funkysub-commits/solar_car/docs/SolarCarChallenge2026_Checklist Andy.md

# Solar Car Challenge 2026

Team Checklist — Items Outside the Car Build

## Andy notes:

Telemetry systems may have a common ground with the propulsion system, as long as the current draw is low

Liquid Container – Cockpits must be equipped with a plastic liquid container filled with water, which can be easily reached by the driver. The liquid container must be secured from movement such that it cannot roll underneath the brake and throttle controls

Fire Extinguishers – Cockpits must be equipped with a Class C fire extinguisher which can be easily reached by the driver in the event of an emergency. Chase vehicles must also be equipped with either a Class C fire extinguisher (for lead-acid batteries), a Class D fire extinguisher (for Lithium-metal batteries), or an appropriate fire extinguisher for other battery chemistries.

Assembled from the 2026 Solar Car Challenge (solarcarchallenge.org) rules and event calendar. Verify every item and date against your current copy of the rules, event updates, and the “Where-to-Be, What-to-Do” document before relying on this list.

“High Voltage” warning signs

Fasteners – All fasteners associated with the vehicle’s suspension, steering, brakes, seat belts, and drive train must be equipped with locking nuts, double nuts, or nuts secured with safety wire or Copyright (c) 2025 Lehman Marks. All Rights Reserved. cotter pins. Loctite may be used in areas of difficult accessibility. When nylon locking nuts are used, the bolt must extend past the nut by at least two threads

Sponsored Graphics – Teams must reserve a space 10" (horizontal) by 10" (vertical) on both sides of the vehicle for official event graphics. The sponsor graphics location should be near the front of the solar car.

Charging accessory battery..?

welding curtain

add email address to iphone group chat so we can see messages on ipad?

“how to receive message on ipad with no phone number with imessage”

All support vehicles on the course must have roof-mounted flashing amber lights mounted at the rear of the vehicle.

Umbilical Cord – To position a solar car’s solar array in a favorable position for charging, an umbilical cord may be used. This cord must be carried on the solar car

Prop car up to face the sun?

### Support Vehicles & Convoy

| **✓** | **Item** | **Owner** | **Deadline / Notes** |
| --- | --- | --- | --- |
| ☐ | Lead vehicle for cross-country events |  |  |
| ☐ | Chase vehicle(s); No. 1 chase must have front-seat space for the event judge |  |  |
| ☐ | Two-way radios for the caravan (car ↔ chase ↔ lead) |  |  |
| ☐ | Radio communication link between support vehicles |  |  |
| ☐ | Amber flashers / warning lights on support vehicles |  |  |
| ☐ | Truck and trailer for trailering the car |  |  |
| ☐ | Support-vehicle signage / team identification |  |  |

### On-Road & Pit Safety Equipment

| **✓** | **Item** | **Owner** | **Deadline / Notes** |
| --- | --- | --- | --- |
| ☐ | Traffic cones or warning triangles |  |  |
| ☐ | Orange warning flags |  |  |
| ☐ | Safety vests (driver, safety officer, anyone on track or road) |  |  |
| ☐ | Jack stands (required whenever car is worked on) |  |  |
| ☐ | Fire extinguisher – at least one with 10 lb capacity |  |  |
| ☐ | Cockpit fire extinguisher – Class C, within driver's reach |  |  |
| ☐ | Chase-vehicle extinguisher – Class C (lead-acid) / Class D (lithium-metal) / battery-appropriate |  |  |
| ☐ | First-aid supplies |  |  |
| ☐ | Protective eyewear for garage work (penalty if not worn) |  |  |

### Battery / Electrical Safety

| **✓** | **Item** | **Owner** | **Deadline / Notes** |
| --- | --- | --- | --- |
| ☐ | Battery spill kit (box of baking soda), in reach of driver – lead-acid teams |  |  |
| ☐ | Second battery spill kit – lead-acid teams |  |  |

### Driver Gear

| **✓** | **Item** | **Owner** | **Deadline / Notes** |
| --- | --- | --- | --- |
| ☐ | Helmet (not mandatory, highly recommended) |  |  |

### Required Documents & Submissions

| **✓** | **Item** | **Owner** | **Deadline / Notes** |
| --- | --- | --- | --- |
| ☐ | Intent to Race filing |  | Deadline Jan 31, 2026 |
| ☐ | Official Registration Documents & Fees |  | Deadline Mar 1, 2026 |
| ☐ | Proof of liability insurance on the car |  | By Jun 1, 2026 (cross-country) |
| ☐ | Team scrapbook – digital copy (becomes SCC property) |  | Deadline Jun 15, 2026 |
| ☐ | Team video |  | Deadline Jul 1, 2026 |
| ☐ | Oral presentation with visual aids |  | At event |
| ☐ | Release-of-liability forms |  | Per event updates |

### Team Logistics & Provisions

| **✓** | **Item** | **Owner** | **Deadline / Notes** |
| --- | --- | --- | --- |
| ☐ | Chaperones / adult supervision |  |  |
| ☐ | Team ID tags – event provides up to 15; larger teams arrange in advance |  |  |
| ☐ | Water beyond event-provided points (start, required stops, impound, qualifiers) |  |  |
| ☐ | Toolboxes by task (front/rear tire changes, mechanical, electrical) |  |  |
| ☐ | Lodging, meals, and fuel for cross-country |  |  |

> [!TIP]
> the longest-lead items are usually the support vehicles, radios, trailer, and insurance — start those first.
