funkysub-commits/solar_car/docs/QR codes.md

## Telemetry User Guide

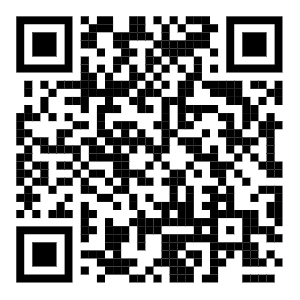
[picture p10: docs/QR codes_images/image-000.png]


## Map with elevation

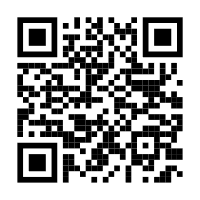
[picture p11: docs/QR codes_images/image-001.png]


## Telemetry Code Design Docs

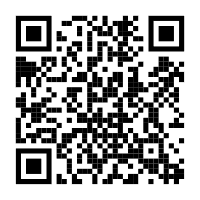
[picture p12: docs/QR codes_images/image-002.png]
Design Docs
