funkysub-commits/solar_car/data_processing/team_pack/2026-10-03/details/figures/drive_06.png

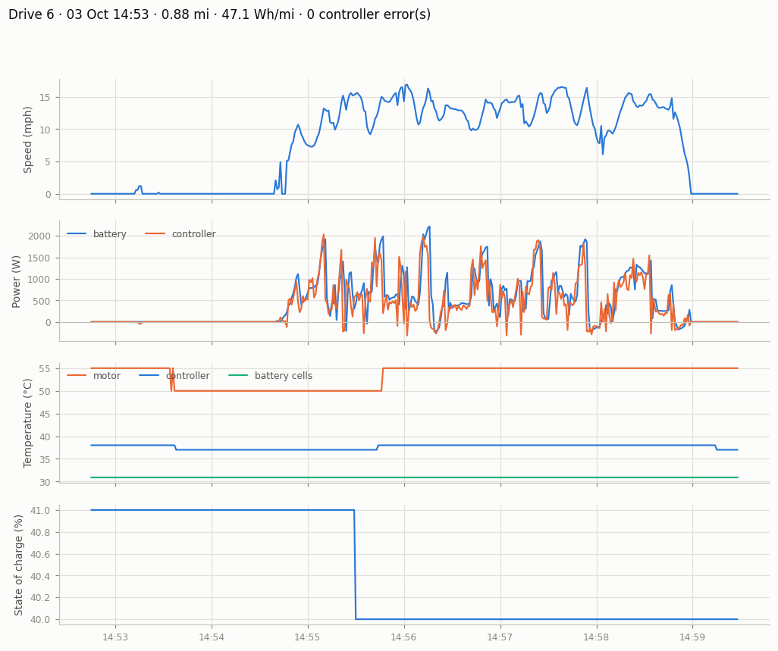
data_processing/team_pack/2026-10-03/details/figures/drive_06.png
