funkysub-commits/solar_car/readme_assets/ha_app.png

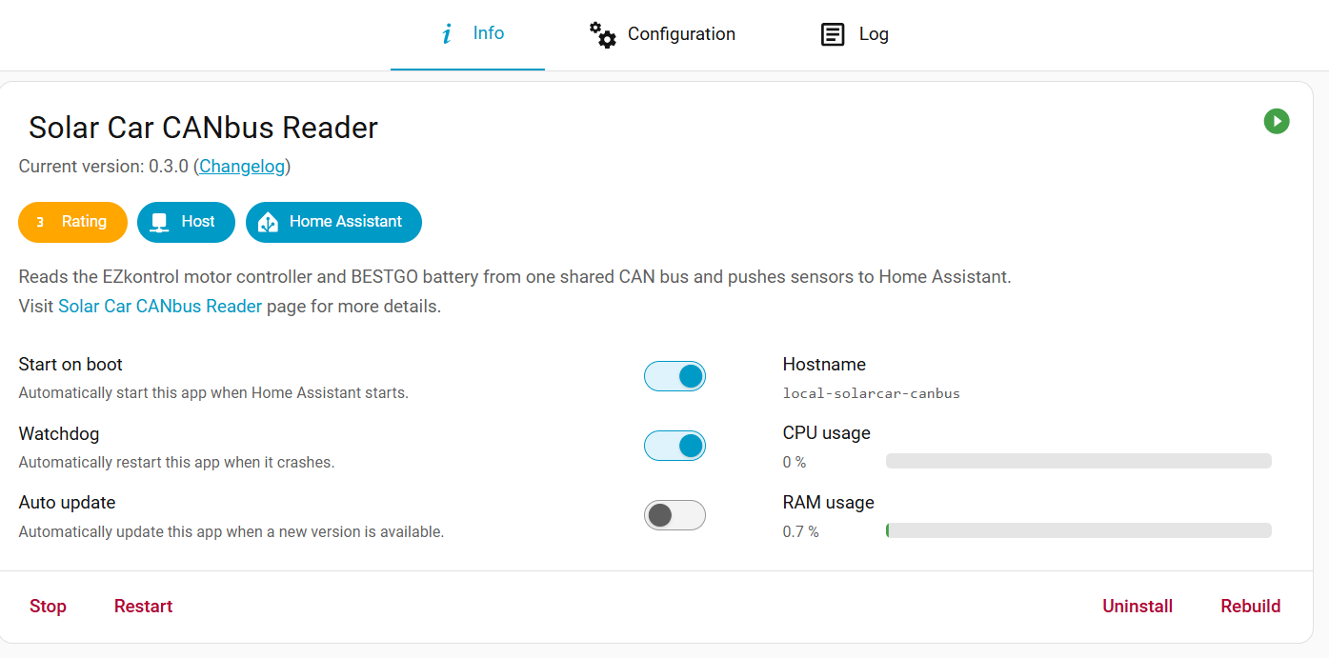
readme_assets/ha_app.png
