funkysub-commits/solar_car/TODO.md

# To Do

- [ ] Make the can bus work with both devices!!!
    - [ ] Check the wiring
    - [x] Manually review code
    - [x] AI review code
- [ ] Fix the can adapter having to power cycle
- [ ] Add startup checklist to power off screen - text box in config
- [x] Add mph calculator
- [ ] Calculate distance/odometer
- [ ] Calculate kw per mile over the last mile?
- [ ] Add estimated remaining miles - based on current pace
- [ ] Connect aux bat to the bms_ble add on - needs update to HAOS
- [x] hardware connection for aux bat to router and pi
- [x] Implement audio player
- [ ] Physically add audio player to car
- [X] Add IP address QR codes to home assistant page
- [x] Add a (physical) switch to the power to the pi and router
- [x] Retain entity values on restart
- [ ] Manage documentation
    - [ ] Finish Evana telemetry userguide
    - [ ] show travelers how to add hotspot and enable/test tailscale from Euan/Andy device over the internet
- [x] Eat an ice cream bar
- [x] Eat another ice cream bar
- [x] Eat a popsicle, or 2
- [x] Eat some oreos
