funkysub-commits/solar_car/CANbus_data/ha_addons/solar-car-canbus/can_reader.py

#!/usr/bin/env python3
"""Solar Car CANbus reader for Home Assistant.

Reads two devices from ONE shared CAN bus (an SH-C31G on slcan firmware,
opened as a serial port via python-can) and pushes named sensor states to HA
via the REST API:

  * EZkontrol B48800 motor controller  -- 29-bit extended IDs (0x1801xxxx)
  * BESTGO battery (Lithium Valley BMS) -- 11-bit standard IDs (0x351..0x379)

The ID ranges don't overlap, so a single socket sees and decodes both. Each
device has an independent push interval and dummy-mode flag, set in the
add-on options and passed through by run.sh as environment variables.

The frame protocols live in the shared solarcar_can package; the copy next
to this file is VENDORED from CANbus_data/solarcar_can/ by sync_addon.py
(HA builds local add-ons with this folder as the Docker context, so the
package has to be carried inside it). Edit the original, then re-sync.
"""
import os
import glob
import time
import queue
import socket
import struct
import logging
import threading

import requests

from solarcar_can import bestgo, ezkontrol
from solarcar_can.bestgo import BestgoDecoder, BG_SENSORS
from solarcar_can.ezkontrol import EzkontrolDecoder, EZ_SENSORS
import telemetry_export

logging.basicConfig(level=logging.INFO,
                    format='%(asctime)s %(levelname)s %(message)s')

HA_URL = os.environ.get("HA_URL", "http://supervisor/core")
HA_TOKEN = os.environ.get("HA_TOKEN", "")
CAN_PORT = os.environ.get("CAN_PORT", "")   # slcan serial port; "" = auto-detect
CAN_BITRATE = os.environ.get("CAN_BITRATE", "500000")

BUS_RETRY_SEC = 10       # how often to retry opening a lost/missing CAN bus
STATUS_MISS_INTERVALS = 3  # device status drops to 0 after this many silent push intervals
NET_INTERVAL = 10        # seconds between host-network checks (runs off-thread)
NET_TIMEOUT = 1.5        # per-probe TCP connect timeout
PUSH_QUEUE_MAX = 256     # pending HA pushes; oldest dropped first when HA lags

EZKONTROL_DUMMY = os.environ.get("EZKONTROL_DUMMY", "false").lower() == "true"
EZKONTROL_PUSH_INTERVAL = int(os.environ.get("EZKONTROL_PUSH_INTERVAL", "2"))
BESTGO_DUMMY = os.environ.get("BESTGO_DUMMY", "false").lower() == "true"
BESTGO_PUSH_INTERVAL = int(os.environ.get("BESTGO_PUSH_INTERVAL", "5"))

# Live update interval: the HA number helper INTERVAL_ENTITY (seconds) is
# polled every CONTROL_POLL_SEC and, when present, overrides BOTH devices'
# push intervals (and so how finely HA records history) -- changeable from the
# dashboard at any time, no restart. Without the helper each device uses its
# configured push interval. Values are clamped to [INTERVAL_MIN, INTERVAL_MAX].
# Only values that CHANGED are re-POSTed faster than a device's configured
# interval (HA ignores identical states anyway, so this only saves HTTP load);
# unchanged values are still re-sent at the configured cadence.
INTERVAL_ENTITY = os.environ.get("INTERVAL_ENTITY", "input_number.canbus_update_interval")
INTERVAL_MIN, INTERVAL_MAX = 0.1, 60.0
CONTROL_POLL_SEC = 2.0   # how often the HA helper is re-read

# Telemetry export (telemetry_export.py): nothing is logged to disk; on
# request the add-on pulls the recorded history of every telemetry entity
# from HA and streams one wide CSV. EXPORT_EXTRA_ENTITIES adds entities the
# add-on doesn't own (e.g. the rpm->mph template sensor); missing ones are
# simply blank columns.
EXPORT_PORT = int(os.environ.get("EXPORT_PORT", "8099"))   # fixed: ingress_port in config.yaml
EXPORT_EXTRA_ENTITIES = [e.strip() for e in os.environ.get("EXPORT_EXTRA_ENTITIES", "").split(",")
                         if e.strip()]

HEADERS = {
    "Authorization": f"Bearer {HA_TOKEN}",
    "Content-Type": "application/json",
}


class Device:
    """One CAN device: its decoder, dummy generator, sensors and push timer."""

    def __init__(self, name, prefix, dummy, push_interval,
                 decoder, dummy_fn, sensors, summary_fn):
        self.name = name
        self.prefix = prefix
        self.dummy = dummy
        self.push_interval = push_interval
        self.decoder = decoder
        self.dummy_fn = dummy_fn
        self.sensors = sensors
        self.summary_fn = summary_fn
        self.data = {}
        self.good_data = False
        self.last_push = 0.0
        self.last_summary = 0.0      # last summary log line (throttled to push_interval)
        self.last_status_push = 0.0  # status sensor keeps the configured cadence
        self.last_rx = 0.0       # when this device last claimed a frame (monotonic)
        self.last_status = None  # last pushed status value (for change logging)

    def decode(self, arb_id, raw):
        """Decode a frame into self.data. Return True if it belonged here."""
        fields = self.decoder.decode(arb_id, raw)
        if fields is None:
            return False
        self.data.update(fields)
        self.last_rx = time.monotonic()
        return True

    def status(self, now):
        """1 if this device is alive: dummy mode counts as alive; live mode
        requires a frame within STATUS_MISS_INTERVALS push intervals. Always
        judged against the CONFIGURED interval, so a fast live interval never
        makes a healthy device read 0."""
        if self.dummy:
            return 1
        return 1 if (now - self.last_rx) <= STATUS_MISS_INTERVALS * self.push_interval else 0

    def effective_interval(self, live):
        """Seconds between pushes right now: the live HA setting when the
        helper exists, otherwise this device's configured interval."""
        return live if live is not None else self.push_interval


# entity_id -> (last pushed value as str, monotonic time it was queued).
# Used by push_device to skip re-POSTing an unchanged value sooner than the
# device's configured interval: identical state+attributes don't even bump
# last_updated in HA, so the request would be pure load on the Pi. The value
# is still re-sent once the configured interval has elapsed, so a restarted
# HA gets everything back within one cycle exactly as before. (At or above
# the configured interval this never skips anything.)
_last_sent = {}


def push_device(device, now=None):
    """POST the decoded fields of `device` to the HA REST API as sensors.

    Only fields listed in the device's sensor table are pushed; extra
    decoded fields (soc_hi, chemistry, life) stay dashboard-only so the
    published sensor set doesn't change.
    """
    now = time.monotonic() if now is None else now
    for key, value in device.data.items():
        cfg = device.sensors.get(key)
        if cfg is None:
            continue
        entity_id = f"sensor.{device.prefix}_{key}"
        prev = _last_sent.get(entity_id)
        if prev and prev[0] == str(value) and now - prev[1] < device.push_interval:
            continue
        _last_sent[entity_id] = (str(value), now)
        attrs = {
            "friendly_name": f"{device.name} {key.replace('_', ' ').title()}",
            "icon":          cfg.get("icon", "mdi:information"),
            "source":        "solar_car_canbus",
        }
        if cfg.get("unit"):
            attrs["unit_of_measurement"] = cfg["unit"]
        if cfg.get("device_class"):
            attrs["device_class"] = cfg["device_class"]
        push_state(entity_id, value, attrs)


# HTTP pushes run on their own thread (state_pusher below). Callers only
# enqueue, so a slow or restarting HA can never stall bus.recv() - blocking
# the read loop lets the kernel RX buffer overflow and silently drop frames.
_push_q = queue.Queue(maxsize=PUSH_QUEUE_MAX)
_push_drops = 0
_push_drop_logged = 0.0


def push_state(entity_id, value, attrs):
    """Queue one entity state for the pusher thread. Never blocks: when the
    queue is full (HA badly behind) the OLDEST update is dropped - every
    sensor is re-pushed each interval, so fresh values win."""
    global _push_drops, _push_drop_logged
    while True:
        try:
            _push_q.put_nowait((entity_id, value, attrs))
            return
        except queue.Full:
            try:
                _push_q.get_nowait()
                _push_drops += 1
            except queue.Empty:
                pass
            now = time.monotonic()
            if now - _push_drop_logged >= 30:
                _push_drop_logged = now
                logging.warning(f"push queue full - dropped {_push_drops} stale "
                                "updates so far (HA slow/unreachable?)")


def state_pusher(stop):
    """Daemon loop: POST queued entity states to the HA REST API."""
    session = requests.Session()
    while not stop.is_set():
        try:
            entity_id, value, attrs = _push_q.get(timeout=0.5)
        except queue.Empty:
            continue
        try:
            r = session.post(
                f"{HA_URL}/api/states/{entity_id}",
                headers=HEADERS,
                json={"state": str(value), "attributes": attrs},
                timeout=5,
            )
            if r.status_code not in (200, 201):
                logging.warning(f"{entity_id}: HTTP {r.status_code} {r.text[:200]}")
        except Exception as e:
            logging.error(f"{entity_id}: {e}")


class IntervalControl:
    """Mirrors the HA number helper INTERVAL_ENTITY (seconds between updates)
    into a thread-safe value. Polled on its own thread so the GET can never
    stall the CAN read loop. `value` is None while the helper is missing or
    unreadable (devices then fall back to their configured intervals), with
    a one-time hint in the log on how to create it."""

    def __init__(self):
        self._value = None
        self._lock = threading.Lock()
        self.missing_logged = False

    @property
    def value(self):
        with self._lock:
            return self._value

    def _set(self, v):
        with self._lock:
            old, self._value = self._value, v
        if v != old:
            if v is None:
                logging.info("update interval -> per-device configured intervals (helper unavailable)")
            else:
                logging.info(f"update interval -> {v:g}s (from {INTERVAL_ENTITY})")

    def run(self, stop):
        session = requests.Session()
        while not stop.is_set():
            try:
                r = session.get(f"{HA_URL}/api/states/{INTERVAL_ENTITY}",
                                headers=HEADERS, timeout=5)
                if r.status_code == 200:
                    state = r.json().get("state")
                    try:
                        v = min(INTERVAL_MAX, max(INTERVAL_MIN, float(state)))
                        self._set(round(v, 3))
                    except (TypeError, ValueError):     # unknown/unavailable
                        self._set(None)
                    self.missing_logged = False
                elif r.status_code == 404:
                    if not self.missing_logged:
                        logging.warning(
                            f"{INTERVAL_ENTITY} not found in HA: using the configured push "
                            "intervals. Create a Number helper with that entity id (or deploy "
                            "CANbus_data/ha/packages/canbus_controls.yaml).")
                        self.missing_logged = True
                    self._set(None)
                else:
                    logging.warning(f"interval poll: HTTP {r.status_code}")
            except Exception as e:
                logging.debug(f"interval poll: {e}")   # HA down: keep last value
            stop.wait(CONTROL_POLL_SEC)


INTERVAL = IntervalControl()


def push_device_status(device, now):
    """Push sensor.<prefix>_status (1 = alive, 0 = silent). Logs transitions."""
    val = device.status(now)
    if val != device.last_status:
        logging.info(f"{device.name} status -> {val}"
                     + ("" if val else f" (no frames for {STATUS_MISS_INTERVALS}x{device.push_interval}s)"))
        device.last_status = val
    push_state(f"sensor.{device.prefix}_status", val, {
        "friendly_name": f"{device.name} Status",
        "icon": "mdi:check-network" if val else "mdi:close-network",
        "source": "solar_car_canbus",
    })


def push_adapter_status(val):
    """Push sensor.canadapter_status (1 = CAN bus open, 0 = adapter missing/lost)."""
    push_state("sensor.canadapter_status", val, {
        "friendly_name": "CAN Adapter Status",
        "icon": "mdi:usb-port" if val else "mdi:usb-off",
        "source": "solar_car_canbus",
    })


# ===========================================================================
# Host network monitoring
#
# Runs on its own thread (NetworkMonitor) so its blocking TCP probes never
# stall the CAN read loop. The add-on has host_network, so these see the
# host's real interfaces -- the address other machines reach HA at, not HA
# core's internal container IP (which the built-in local_ip sensor reports).
# ===========================================================================
def host_ip():
    """Primary LAN IPv4 of the host, via the default-route source-IP trick
    (no packets sent). None when there's no usable LAN address."""
    ip = None
    s = socket.socket(socket.AF_INET, socket.SOCK_DGRAM)
    try:
        s.connect(("1.1.1.1", 80))   # picks the source IP for the default route
        ip = s.getsockname()[0]
    except OSError:
        pass
    finally:
        s.close()
    if ip and not ip.startswith("127."):
        return ip
    try:                              # fallback when there is no default route
        for info in socket.getaddrinfo(socket.gethostname(), None, socket.AF_INET):
            cand = info[4][0]
            if not cand.startswith("127."):
                return cand
    except OSError:
        pass
    return None


def default_gateway():
    """The host's default-route gateway IPv4 (read live from /proc/net/route,
    so it tracks network changes -- router vs hotspot vs ethernet). None if
    there is no default route."""
    try:
        with open("/proc/net/route") as f:
            for line in f.readlines()[1:]:
                p = line.split()
                if len(p) > 3 and p[1] == "00000000" and int(p[3], 16) & 0x2:
                    return socket.inet_ntoa(struct.pack("<L", int(p[2], 16)))
    except (OSError, ValueError):     # ValueError: malformed hex field
        pass
    return None


def tcp_reachable(host, ports, timeout=NET_TIMEOUT):
    """True if `host` answers at L3 on any of `ports`. A refused connection
    (RST) still proves reachability, so this works against gateways with no
    open ports -- only a timeout / no-route counts as unreachable."""
    if not host:
        return False
    for port in ports:
        try:
            socket.create_connection((host, port), timeout=timeout).close()
            return True
        except ConnectionRefusedError:
            return True
        except OSError:
            continue
    return False


def push_connectivity(entity_id, ok, name, icon_on, icon_off):
    """Push a binary_sensor (connectivity) as on/off."""
    push_state(entity_id, "on" if ok else "off", {
        "friendly_name": name,
        "device_class": "connectivity",
        "icon": icon_on if ok else icon_off,
        "source": "solar_car_canbus",
    })


def network_monitor(stop):
    """Daemon loop: every NET_INTERVAL, publish the host IP and the LAN/WAN
    reachability sensors. Kept off the main loop so the TCP probes' timeouts
    can never delay CAN frame reading."""
    last = None
    while not stop.is_set():
        # One guard around the whole probe cycle: an unforeseen error must not
        # kill the thread, or the network sensors would silently freeze at
        # their last values for the rest of the add-on's life.
        try:
            ip = host_ip()
            gw = default_gateway()
            lan = tcp_reachable(gw, (80, 443, 53)) if gw else bool(ip)
            wan = tcp_reachable("1.1.1.1", (53,)) or tcp_reachable("8.8.8.8", (53,))

            push_state("sensor.haos_ip_address", ip or "unknown", {
                "friendly_name": "HAOS IP Address",
                "icon": "mdi:ip-network",
                "source": "solar_car_canbus",
            })
            push_state("sensor.network_status", 1 if ip else 0, {
                "friendly_name": "Network Status",
                "icon": "mdi:lan-connect" if ip else "mdi:lan-disconnect",
                "source": "solar_car_canbus",
            })
            push_connectivity("binary_sensor.lan_connected", lan, "LAN Connected",
                              "mdi:lan-connect", "mdi:lan-disconnect")
            push_connectivity("binary_sensor.wan_connected", wan, "WAN Connected",
                              "mdi:web", "mdi:web-off")

            cur = (ip, lan, wan)
            if cur != last:
                logging.info(f"network: ip={ip or 'none'} "
                             f"lan={'up' if lan else 'down'} "
                             f"wan={'up' if wan else 'down'}")
                last = cur
        except Exception:
            logging.exception("network monitor: probe cycle failed; retrying")
        stop.wait(NET_INTERVAL)


def can0_ready():
    """True if can0 exists and isn't down. The SH-C31G on candlelight/gs_usb
    firmware is exposed by the kernel gs_usb driver as SocketCAN can0; run.sh
    sets its bitrate and brings it up. Re-checked each retry so a replugged
    adapter is picked up without restarting the add-on. (CAN links report
    operstate 'unknown' when UP, so anything but 'down' counts as ready.)"""
    try:
        with open("/sys/class/net/can0/operstate") as f:
            return f.read().strip() != "down"
    except OSError:
        return False


def open_bus():
    """Open can0 via SocketCAN with python-can. Returns a Bus or None.

    The SH-C31G runs candlelight/gs_usb firmware; the kernel gs_usb driver
    exposes it as can0 and run.sh sets the bitrate + brings it up. (The earlier
    "gs_usb/SocketCAN is broken on HAOS" theory was a sleeping-battery confound
    -- once the BMS is broadcasting, can0 receives fine, confirmed 2026-06-29.)
    Returns None if can0 isn't ready -- the caller keeps retrying and reports
    canadapter_status=0 meanwhile."""
    import can
    if not can0_ready():
        return None
    try:
        return can.Bus(interface="socketcan", channel="can0")
    except Exception as e:
        logging.debug(f"socketcan open failed on can0: {e}")
        return None


EZKONTROL = Device(
    name="EZkontrol", prefix="ezkontrol",
    dummy=EZKONTROL_DUMMY, push_interval=EZKONTROL_PUSH_INTERVAL,
    decoder=EzkontrolDecoder(), dummy_fn=ezkontrol.dummy_fields,
    sensors=EZ_SENSORS,
    summary_fn=lambda d: (f"V={d.get('bus_voltage')} I={d.get('bus_current')} "
                          f"RPM={d.get('motor_speed')} CT={d.get('controller_temp')}"),
)
BESTGO = Device(
    name="BESTGO", prefix="bestgo",
    dummy=BESTGO_DUMMY, push_interval=BESTGO_PUSH_INTERVAL,
    decoder=BestgoDecoder(), dummy_fn=bestgo.dummy_fields,
    sensors=BG_SENSORS,
    summary_fn=lambda d: (f"V={d.get('pack_voltage')} I={d.get('pack_current')} "
                          f"SOC={d.get('soc')}% T={d.get('pack_temp')}"),
)


def export_entities(devices):
    """Entity ids the export covers, in CSV column order: the health sensors,
    every published sensor of every device, then the configured extras."""
    ids = ["sensor.canadapter_status"] + [f"sensor.{d.prefix}_status" for d in devices]
    ids += [f"sensor.{d.prefix}_{k}" for d in devices for k in d.sensors]
    for e in EXPORT_EXTRA_ENTITIES:
        if e not in ids:
            ids.append(e)
    return ids


def main():
    logging.info("Solar Car CAN Reader starting")
    logging.info(f"  EZkontrol: dummy={EZKONTROL_DUMMY} push={EZKONTROL_PUSH_INTERVAL}s")
    logging.info(f"  BESTGO:    dummy={BESTGO_DUMMY} push={BESTGO_PUSH_INTERVAL}s")
    logging.info(f"  Live interval: {INTERVAL_ENTITY} (seconds; overrides both when present)")
    logging.info(f"  Telemetry export: on :{EXPORT_PORT} from HA history"
                 + (f"; extra entities {EXPORT_EXTRA_ENTITIES}" if EXPORT_EXTRA_ENTITIES else ""))
    if not HA_TOKEN:
        logging.warning("HA_TOKEN is empty; REST pushes will fail")

    devices = [BESTGO, EZKONTROL]
    live = [d for d in devices if not d.dummy]

    bus = None
    bus_retry_at = 0.0
    adapter_pushed = None    # last pushed canadapter_status value
    adapter_push_at = 0.0
    adapter_interval = min(d.push_interval for d in devices)

    # Network monitoring, HA pushes and the interval-helper poll run on their
    # own threads so neither blocking TCP probes nor slow HTTP ever delay CAN
    # reads.
    stop = threading.Event()
    threading.Thread(target=network_monitor, args=(stop,),
                     name="network-monitor", daemon=True).start()
    threading.Thread(target=state_pusher, args=(stop,),
                     name="state-pusher", daemon=True).start()
    threading.Thread(target=INTERVAL.run, args=(stop,),
                     name="interval-control", daemon=True).start()

    # On-demand telemetry export (HA history -> CSV) on its own server thread.
    def fastest_interval(live):
        return live if live is not None else min(d.push_interval for d in devices)

    def export_state():
        live = INTERVAL.value
        return {"interval": fastest_interval(live),
                "interval_source": INTERVAL_ENTITY if live is not None else "add-on options"}
    # The entity list is editable from the export page; the add-on's own
    # sensors (+ configured extras) are the defaults it can be reset to.
    telemetry_export.start_export_server(
        EXPORT_PORT, telemetry_export.HAHistory(HA_URL, HA_TOKEN),
        telemetry_export.EntitySelection(export_entities(devices)), export_state)

    if live:
        bus = open_bus()
        if bus is not None:
            logging.info(f"can0 open (SocketCAN @ {CAN_BITRATE} bps); "
                         "listening (live: " + ", ".join(d.name for d in live) + ")")
        else:
            logging.error("can0 not ready; will keep retrying "
                          f"every {BUS_RETRY_SEC}s (canadapter_status=0)")
    else:
        logging.info("All devices in dummy mode; CAN bus not opened")

    try:
        while True:
            # All scheduling uses time.monotonic(): the Pi has no RTC, so NTP
            # steps the wall clock whenever the hotspot connects - a backward
            # step froze every push (and retry) for the step duration, and a
            # forward step published spurious status=0 transitions.
            now = time.monotonic()
            if live and bus is None and now >= bus_retry_at:
                bus_retry_at = now + BUS_RETRY_SEC
                bus = open_bus()
                if bus is not None:
                    logging.info("can0 recovered; listening again")

            if bus is not None:
                try:
                    msg = bus.recv(timeout=0.2)
                except Exception as e:
                    logging.error(f"CAN bus lost: {e}")
                    try:
                        bus.shutdown()
                    except Exception:
                        pass
                    bus = None
                    msg = None
                if msg is not None:
                    raw = bytes(msg.data)
                    # A frame belongs to exactly one device (disjoint arbitration
                    # ids), so stop at the owner. Only SET the owner's flag - never
                    # touch the others, or a frame for one device would clear the
                    # other's "fresh data" flag and stall its pushes.
                    for d in live:
                        if d.decode(msg.arbitration_id, raw):
                            d.good_data = True
                            break
                elif bus is not None and not can0_ready():
                    # socketcan recv() just times out (no exception) when the
                    # link goes down while the netdev still exists - catch it
                    # here so canadapter_status doesn't keep claiming 1.
                    logging.error("can0 went down; will keep retrying "
                                  f"every {BUS_RETRY_SEC}s (canadapter_status=0)")
                    try:
                        bus.shutdown()
                    except Exception:
                        pass
                    bus = None
            else:
                # No bus to block on: nap, but short enough to honour a fast
                # live interval in dummy mode.
                time.sleep(min(0.2, fastest_interval(INTERVAL.value) / 2))

            now = time.monotonic()
            ivl = INTERVAL.value           # None = use configured intervals

            # canadapter_status: 1 while the bus is open (all-dummy counts
            # as 1). Pushed on every change and at least every push interval.
            adapter_ok = 1 if (not live or bus is not None) else 0
            if adapter_ok != adapter_pushed or now - adapter_push_at >= adapter_interval:
                if adapter_ok != adapter_pushed:
                    logging.info(f"CAN adapter status -> {adapter_ok}")
                push_adapter_status(adapter_ok)
                adapter_pushed = adapter_ok
                adapter_push_at = now

            for d in devices:
                if now - d.last_push < d.effective_interval(ivl):
                    continue
                d.last_push = now
                if d.dummy:
                    d.data = d.dummy_fn()
                    d.good_data = True        # dummy data is always fresh
                if d.good_data:
                    push_device(d, now)
                    d.good_data = False       # consume: the next push needs a new frame
                    # The per-push summary line would flood the log at a fast
                    # live interval; keep it at the configured cadence.
                    if now - d.last_summary >= d.push_interval:
                        d.last_summary = now
                        logging.info(f"{d.name}: {d.summary_fn(d.data)}")
                # Status is pushed every interval even with no data, so a
                # silent device reads 0 instead of having missing sensors.
                # (Status itself stays on the configured cadence.)
                if now - d.last_status_push >= d.push_interval:
                    d.last_status_push = now
                    push_device_status(d, now)

    except KeyboardInterrupt:
        logging.info("Shutting down")
    finally:
        stop.set()
        if bus is not None:
            bus.shutdown()


if __name__ == "__main__":
    main()
