funkysub-commits/solar_car/(commit log)

2026-05-16 update battery testing
2026-05-16 add battery data files
2026-05-17 Update battery testing scripts
2026-05-17 add bms_gui_usage.md
2026-05-19 add can bus data
2026-05-20 Reorganize repo into pc_files/, rp_files/, ha_addons/, specs/
    - pc_files/: device scripts (bestgo_probe, ezkontrol_decode) +
    testing/ for adapter bring-up tools (smoke_test, probe_timing, sniff)
    - rp_files/: placeholder for future Raspberry Pi direct tools
    - ha_addons/: HA add-on plus the ha_push/ha_run deploy helpers
    - specs/: ezkontrol + bestgo spec text, new bestgo_spec.txt for the
    SMA/Pylontech-compatible BMS protocol, and source reference PDFs
2026-05-20 Add dummy modes, combined monitor, and Raspberry Pi SocketCAN port
    PC tools (pc_files/):
    - bestgo_decode.py: live dashboard + ASC logger for the BESTGO BMS
    - monitor.py: combined dashboard, both devices on one shared 500 kbps bus
    - ezkontrol_decode.py: -ezkontrol_dummy mode + 250/500 kbps switch
    - all decoders gain -*_dummy hardware-free simulation modes
    Raspberry Pi port (rp_files/):
    - SocketCAN versions of all three dashboards (python-can socketcan
    backend; the SH-C31G is handled by the kernel gs_usb module as can0)
    - can_up.sh interface bring-up helper, requirements.txt, SETUP.md
    - testing/sniff.py, testing/smoke_test.py
    Environment:
    - venv relocated to repo root (gitignored); require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
2026-05-21 Add Solar Storms e-ink dashboard add-on and telemetry simulator
    display/addon: e-ink telemetry dashboard for the Waveshare 7.5" V2,
    packaged as a Home Assistant add-on (config.yaml/build.yaml/Dockerfile/
    run.sh):
    - mph speedometer (rpm->mph via wheel size + gear ratio), team logo
    header, battery SoC/voltage, four temperature bar graphs, and a
    messages area for temp warnings / messages from HA
    - region-limited partial refresh and idle deep-sleep to extend panel life
    - reads the real ezkontrol_* and bestgo_* sensor entities
    simulator: telemetry simulator that feeds realistic, continuously
    changing dummy data to those entities until the CAN/BMS hardware is
    connected.
    .gitignore: ignore we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
2026-05-21 Combine CAN add-ons into solar-car-canbus add-on
    Evolve the ezkontrol-canbus add-on into solar-car-canbus: a single
    add-on that decodes both the EZkontrol B48800 motor controller and the
    BESTGO battery from one shared 500 kbps CAN bus, with independent
    per-device push intervals and dummy-mode flags.
    - run.sh auto-recovers the SH-C31G USB-CAN adapter from STM32 DFU mode
    via a uhubctl USB port power-cycle when can0 is missing.
    - Add bestgo_docker_test/: a standalone container for bench-testing
    BESTGO frame decoding.
    - specs: document the shared single-bus topology (EZkontrol set from
    250k to 500k); add-on CAN bitrate default is now 500000.
    - Stop tracking .claude/settings.local.json and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
    [bestgo_logtest.py, can_reader.py, config.yaml]
2026-05-21 README: document the solar-car-canbus app; fix image links
    - Rewrite sections 6.3/6.4 for the solar-car-canbus HA app, replacing
    the old standalone can-reader Docker container: one app reads the
    EZkontrol motor controller and the BESTGO battery from the shared CAN
    bus (34 sensors), with per-device dummy and push-interval options.
    - 6.2: document the shared 500 kbps bus (EZkontrol set to protocol 102).
    - Section 1 and 8: update the architecture table and maintenance
    commands to the HA app (ha apps ...) instead of the docker container.
    - Fix two broken image links (image.png / image1.png were renamed to
    diagram1.png / diagram2.png).
    - Add a deferred security item to the section 10 to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
2026-05-30 Add temp_unit option and CAN-bus-not-connected display state
    display.py:
    - new TEMP_UNIT option (C/F) - temperatures are read as Celsius then
    converted for display; TEMP_MAX and TEMP_WARN are interpreted in the
    chosen unit. Bar values now show e.g. "25C" / "77F".
    - ha_get now returns last_reported; new entity_age_seconds helper plus
    per-CAN-entity timestamp tracking. When every CAN-fed entity has not
    reported within STALE_AGE seconds (default 60), the display switches
    to a dedicated "CAN bus not connected" frame (render_no_data) instead
    of showing stale readings. read_number/read_temp_c signatures updated
    to return the timestamp alongside the value.
    addon: corresponding temp_u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
2026-05-30 PC scripts: work around gs_usb 0.3.1 short-read crash
    dev.read() passes the exact expected frame size to the USB transfer, so
    a short packet from the adapter raises struct.error in unpack_into and
    kills the script on the first frame. Add a safe_read() helper that
    requests a 64-byte buffer and dispatches on the actual length returned.
    [bestgo_decode.py, bestgo_probe.py, ezkontrol_decode.py]
2026-05-30 README 6.2: correct EZkontrol CAN protocol to 101 (read-only telemetry)
    102 is MCU-to-VCU, which hands throttle/gear/brake to CAN; 101 is the
    500K passive MCU-to-Meter variant we actually want. Add protocol table.
2026-06-09 e-ink: bottom notification toast for all warnings + stale marks + HA hide system
    Replace the full-screen "CAN bus not connected" view with a small, centred
    bottom notification toast that shows the single most important active warning
    (CAN-down > live high temp > stale sensor > user message), with a count badge
    when several are active. Add a "!" mark beside any value whose source entity
    has stopped updating (based on last_reported age), while steady-but-reported
    values stay unmarked.
    The add-on now publishes sensor.eink_warnings and reads input_text.eink_hidden
    (single writer, prunes inactive keys) so a new Home Assistant dashboard section
    can list every message and hide individual ones from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
    [config.yaml, display.py]
2026-06-09 Andy latest, in the middle of canbus debug
2026-06-10 Security + repo hygiene: scrub credentials, untrack logs/caches
    - Untrack CANbus_data/HA_TOKEN.txt (live HA token; revoke it in HA -
    it remains in git history, treat as compromised)
    - Replace the README's plaintext long-lived token and HA login
    credentials with placeholders; update the security note
    - Untrack .playwright-mcp/, logs/, CANbus_data/logs/, and committed
    display/__pycache__ .pyc files (all stay on disk)
    - Keep two curated CAN captures as decoder test fixtures under
    CANbus_data/tests/fixtures/ (BESTGO + EZkontrol), with provenance README
    - .gitignore: add .playwright-mcp/, logs/, *.log, HA_TOKEN.txt, .env
2026-06-10 Phase 2: consolidate 5 CAN decoder copies into shared solarcar_can package
    The BESTGO and EZkontrol frame decoders existed in five near-identical
    copies (pc_files, rp_files, HA add-on) that had already diverged. They
    now live once, in CANbus_data/solarcar_can/:
    - bestgo.py / ezkontrol.py: parsers, name tables, HA sensor metadata,
    dummy generators. Canonical field names = the HA add-on's (the
    published sensor.{bestgo,ezkontrol}_* set is unchanged). Best-of
    divergences merged: full error descriptions, named op_mode (was a raw
    int in the add-on), per-half battery-name assembly (the old scripts'
    NUL-stop concat dropped the second half), gs_usb safe_read workaround.
    Malformed frames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
    [bestgo.py, bestgo_decode.py, bestgo_probe.py, can_reader.py, config.yaml, ezkontrol.py, ezkontrol_decode.py, golden_reference.py]
2026-06-10 Add PI_TODO.md (running Pi task list) and Phase 3 display refactor plan
    PI_TODO.md tracks everything waiting on the Raspberry Pi being powered:
    token revocation, add-on 0.4.0 deploy + verification, the never-tested
    EZkontrol live decode, plus no-Pi-needed items (push to GitHub).
    display/PHASE3_PLAN.md fully specifies the deferred display.py split
    (module breakdown, bundled bug fixes, golden-image verification, commit
    sequence) so it can be picked up cold.
2026-06-10 Phase 4: peripheral cleanup — merge elevation scripts, archive retired code
    - mapping: fetch_elev_all.py + fetch_elev_day1.py (~80 duplicated lines)
    merged into fetch_elev.py with a --day filter; always emits the
    {"grand","days"} shape build_viewer.py prefers. day1_elev.json deleted
    (strict subset of all_elev.json; viewer fallback path still handles it).
    - archive/ble_bms/: the pre-CAN Bluetooth battery GUI (main.py,
    display/bms_gui.py, bluetooth_testing/). Note: main.py imports
    battery_data.smart_bms, which was never committed — the GUI doesn't run
    from this repo as-is; documented in archive/README.md.
    - archive/bestgo_docker_test/: the standalone Pi decode-validation
    cont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
    [bestgo_gsusb_test.py, bestgo_logtest.py]
2026-06-10 README: reflect phases 0-4 (shared decoder package, no-token apps, current to-dos)
    - §2/§3.4: the HA apps need no long-lived token (Supervisor proxy); a
    token is only for optional PC-side tools, via the HA_TOKEN env var
    - §6.3: document the shared solarcar_can package, the vendored copy +
    sync_addon.py workflow, golden-master tests, and the 0.4.0 op_mode
    string-value change
    - §8: manual bring-up example now shows the actual 500 kbps shared bus
    - §10: stale May CAN-debug checklist replaced with a pointer to
    PI_TODO.md; clarified the 0xAA handshake only applies to the unused
    VCU protocol; refactor work recorded under Complete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
2026-06-11 Race guidance: keep Supervisor updated during the race, not frozen
    Reduces friction if an app needs an emergency fix mid-race — a current
    Supervisor means push -> reload -> update with no Supervisor-update
    detour over a flaky hotspot. Time updates for when the car is stopped
    (brief sensor-push gap while it restarts).
2026-06-11 PI_TODO: PC gs_usb transport test passed (2026-06-11)
    Adapter came up in DFU mode once (BOOT switch) - replug fixed it.
    monitor.py, bestgo_decode.py ASC logging, and mixed live+dummy mode all
    verified on the empty bus via the new solarcar_can transport layer.
2026-06-12 canbus add-on 0.5.x: health-status sensors + survive adapter loss
    Adds three always-pushed health sensors so HA can tell apart "adapter
    dead" / "device silent" / "add-on not running":
    - sensor.canadapter_status: 1 when the CAN bus is open (or all-dummy)
    - sensor.ezkontrol_status / sensor.bestgo_status: 1 when that device
    produced a frame within 3 push intervals (or it's in dummy mode)
    Statuses push every interval regardless of data, so a silent device
    reads 0 instead of leaving sensors missing. The add-on no longer exits
    when the interface is absent: run.sh starts anyway, and can_reader.py
    keeps running, pushes canadapter_status=0, and retries the bus every
    10s — bringing a downed/replu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
    [can_reader.py, config.yaml]
2026-06-12 canbus add-on 0.6.0: host network sensors (IP + up) for the e-ink
    Adds two always-pushed sensors so the chase vehicle (and eventually the
    e-ink) can see how to reach HA and whether the network is up:
    - sensor.haos_ip_address: the host's LAN IP (the address others connect
    to), via the default-route source-IP trick (the add-on has host_network)
    - sensor.network_status: 1 when the host has a usable LAN IP
    Why not the built-in Local IP integration: it runs inside HA core's
    container and reports the internal 172.30.x docker address, not the LAN
    IP — useless for "connect here". The built-in Ping integration IS used
    for internet reachability (binary_sensor.1_1_1_1, set up separately).
    Verifie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
2026-06-12 canbus add-on 0.7.0: LAN/WAN connectivity sensors on a background thread
    Replaces the friendlier-name request + a LAN counterpart with two
    add-on-published connectivity binary_sensors:
    - binary_sensor.wan_connected: internet reachable (TCP 1.1.1.1:53,
    fallback 8.8.8.8) — the "WAN connected" the user asked for
    - binary_sensor.lan_connected: default gateway reachable. The gateway is
    discovered live from /proc/net/route, so it tracks network changes
    (router/hotspot/ethernet) with nothing hardcoded. Uses a TCP probe
    where a refused connection (RST) still counts as reachable, so it works
    against gateways with no open ports.
    Why add-on instead of HA's Ping integration (now removed): t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
    [can_reader.py, config.yaml]
2026-06-12 PI_TODO: live BESTGO decode verified on PC through new code (2026-06-12)
    Real battery decodes correctly through the shared solarcar_can package
    (176 frames, all 14 IDs, ~14 Hz, internally-consistent values). Pi-side
    live decode still unconfirmed: earlier today the Pi showed can0 up but
    rx_packets=0 with the battery -- noted to check termination/wiring when
    the adapter goes back on the Pi, since PC proves battery+decode are good.
2026-06-12 Phase 3 step 1: golden-image harness + baseline hashes for display.py
    36 frames (12 scenarios x 3 config groups) rendered through render() and
    hashed on the raw 1-bit framebuffer, with committed DejaVu fonts so the
    rasterisation is reproducible. FONT_DIR becomes env-overridable (unset =
    unchanged) so the harness can point at the committed fonts.
2026-06-12 Phase 3 step 2: split display.py into focused modules - golden-verified
    965-line monolith becomes config/layout/units/ha_client/alerts/render/panel
    plus a ~290-line display.py entry point (main loop only). Pure code motion:
    all 36 golden framebuffer hashes match the pre-split baseline byte-for-byte.
    Deviation from the plan's naming: warnings.py is alerts.py, because modules
    are copied flat into / on the container where warnings.py would shadow the
    stdlib module that requests/logging import. Dockerfile COPY picks up *.py.
2026-06-12 Speed is HA-native: show the entity's value and unit, no conversion
    The add-on no longer converts rpm to mph/kmh - the speedometer shows the
    configured entity's value and unit_of_measurement exactly as Home Assistant
    reports them. The speed_unit / wheel_diameter_in / gear_ratio options are
    gone; rpm->mph now lives in HA as the sensor.solar_car_speed template sensor
    (display/ha/eink_messages.yaml) and ent_speed points wherever the team wants.
    A unit change refreshes the speed region like any value change. v1.3.0.
    Golden check: the default group's 12 hashes are byte-identical (label text
    'mph' unchanged); fahrenheit/highscale regenerate with km/h / rpm labels.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
    [config.py, config.yaml, display.py, panel.py, render.py, units.py]
2026-06-12 CAN health: bus/battery/EZkontrol connectivity sensors drive the warnings
    The canbus app will publish three health sensors (adapter/bus up, battery on
    CAN, EZkontrol on CAN). The display now reads them - PLACEHOLDER entity ids
    (binary_sensor.solarcar_can_*) until the real names exist - and falls back to
    per-device staleness inference while a sensor is unknown, so behavior today
    is unchanged.
    A device outage marks ! on exactly the values that device feeds: battery down
    -> SoC/voltage/BATT temp only, EZkontrol down -> speed/motor/EZK temps only,
    with 'Battery not on CAN bus' / 'EZkontrol not on CAN bus' toasts (new
    hideable keys can_batt/can_ezk, hide buttons added to the dashboard section).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
2026-06-12 Phase 3 bug fixes: hidden-list fit, loud patch.py, font warning, HA-unreachable
    1. Hidden-key list: fit_hidden() drops the lowest-priority keys (logged) when
    the CSV would exceed input_text's 255-char cap; set_hidden's last-resort
    cut lands on a key boundary instead of corrupting the list mid-key.
    2. patch.py: every replacement is checked - if upstream Waveshare restructures
    epdconfig.py the Docker build fails loudly instead of shipping an add-on
    that crashes at runtime.
    3. Fonts: falling back to PIL's default now logs one warning per face.
    4. HA-unreachable: consecutive request failures are tracked and logged
    (rate-limited, once a minute) and the panel shows 'Home Assistant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
    [alerts.py, display.py, ha_client.py, layout.py, patch.py]
2026-06-12 Wire real CAN-health sensor names (canbus 0.7.0 publishes them)
    The canbus 0.7.0 app publishes sensor.canadapter_status / bestgo_status /
    ezkontrol_status (1=up, 0=down), so the display add-on now defaults the
    three ent_can_* options to these real ids instead of placeholders.
    read_health also returns 'unknown' when the health sensor itself has gone
    stale (its publisher stopped) - a frozen '1' would otherwise mask a real
    outage; unknown falls back to data-staleness inference. +2 unit tests.
2026-06-13 e-ink 1.4.0: message box vs warnings bar, 3 device warnings, fill+overflow bar
    - Plain user message (input_text.eink_message) goes back to its own MESSAGE box
    (bottom-left); only warnings use the bottom bar. Speedometer shrinks to fit.
    - Warning bar fills left->right (highest priority leftmost) and shows a '+N' pill
    at the right for warnings that don't fit.
    - Three INDEPENDENT device warnings, adapter prioritised: CAN adapter (100) >
    BESTGO (96) > EZkontrol (95); high temp capped (<=90) below them. Per-device
    '!' marks (battery dropout marks only SoC/V/BATT, etc.). No more folding.
    - HA dashboard: new dashboard_warnings_section.yaml (lists active warnings, a
    Hide button per active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
2026-06-13 PI_TODO: EZkontrol live decode verified on PC (first ever, 2026-06-13)
    Both frames decode at 500k (controller already on protocol 101). Values
    consistent: 52.0V bus matches battery, status byte gear D2/contactor
    on/mode Normal/no errors, life counter increments. Pi-side still
    unconfirmed (same zero-RX question as BESTGO).
2026-06-13 PI_TODO: full shared-bus decode passed on PC + termination insight
    Both devices (EZkontrol 22Hz + BESTGO 11Hz) decode simultaneously and
    cleanly via monitor.py -- the real race config. Termination: both
    devices connected => adapter 120R switch OFF (devices terminate the two
    ends), verified. Likely explains the Pi zero-RX: a single device needs
    the adapter termination ON to be the second terminator.
2026-06-14 PI_TODO: Pi zero-RX is asymmetric RX, not ground (TX-ACK test 2026-06-13)
    TX-ACK test overturns the 2026-06-08 common-ground theory: cansend from
    the Pi gets a clean ACK (tx 0->1, 0 errors), proving the adapter is
    electrically on the bus and RX works at the bit level. So it's an
    RX-specific failure (can TX+get-ACKed but receives 0 frames) -- suspects
    are bit-timing sync to external frames or a driver RX bug. Recorded the
    next experiment (force PC-exact timing via diag container) and that the
    addon was left stopped.
2026-06-14 Debug plan: Pi zero-RX is asymmetric RX-delivery, not ground
    TX-ACK test disproves the 2026-06-08 common-ground conclusion. New doc
    DEBUG-pi-rx-plan-20260613.md ranks the real suspects (FDCAN reject-all
    filter, kernel gs_usb RX path, USB/power, timing) and gives an ordered,
    discriminating test plan with exact commands for the next Pi session.
    Banner added to the superseded 2026-06-08 doc; PI_TODO points at the plan.
2026-06-15 CANbus_data: tidy for handoff — README front door, docs/, tools/
    Make the directory self-explanatory for a new maintainer:
    - New CANbus_data/README.md is the single entry point: what it is, a
    directory map, quick-start (PC/Pi/dummy), the HA add-on + the deploy
    workflow (previously only in PI_TODO/memory), tests, diagnostics, and a
    link to the debugging history. Folds in and replaces SETUP.md.
    - Move the two DEBUG-pi-*.md journals to CANbus_data/docs/ so the top
    level is just code + README (they cross-ref each other by name, still
    valid together in docs/).
    - Move ha_push.py / ha_run.py (PC-side SSH/deploy helpers, not add-ons)
    from ha_addons/ to tools/, so ha_addons/ contains on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
    [ha_push.py, ha_run.py]
2026-06-16 Pi zero-RX: software ruled out (userspace gs_usb also 0) -> electrical
    Shop session 2026-06-15: userspace gs_usb on the Pi also gets 0 frames
    (clean timeouts, PC-exact timing, continuous traffic), bypassing the
    kernel CAN stack. So not the driver, not timing, not a filter, not
    software. With TX-ACK working + PC working, it's a Pi-host ground/
    common-mode OFFSET. Decisive next test: power the Pi from a floating
    battery/power bank and re-run. Fix direction: galvanically isolated
    USB-CAN adapter.
2026-06-16 Pi RX debug session 2: car-power confound + isolated adapter rules out ground
    Logged that the car was switched off mid-session (EZkontrol stops
    broadcasting → some 0-RX reads were a quiet bus, not a dead receiver),
    and that the adapter is galvanically isolated (rules out the earlier
    ground/common-mode conclusion). Resume plan: confirm car ON, then the
    back-to-back PC check at 250k to prove whether the EZkontrol is actually
    broadcasting before trusting any Pi 0-RX. Flagged that the EZkontrol is
    left at protocol 1 (250k) and must go back to 101 (500k).
2026-06-18 Pi RX solved (kernel gs_usb regression) + slcan migration plan
    Multi-session debug concluded: the Pi received+ACKed CAN frames but never
    delivered them to software — a kernel gs_usb / hardware-timestamp
    regression on the HAOS 6.12 kernel for this STM32G431 candleLight adapter
    (electrical/ground/wiring/bitrate/interfering-software all ruled out; the
    adapter is isolated; a clean-replug test still showed 0 RX). The SH-C31G
    has been reflashed to slcan firmware (CDC-serial, bypasses gs_usb).
    Adds docs/SLCAN_MIGRATION_PLAN.md: validate slcan RX first, then add a
    python-can slcan transport (uniform PC+Pi, default), update the PC tools,
    and the add-on (can_reader bus layer -> slcan, simplified ru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
2026-06-18 README §8: race rule = update once before, then freeze
    The previous 'keep updating the Supervisor during the race' advice was
    backwards for a competition system. Reframe to: get the Supervisor +
    apps current before the race, then freeze. Note the one exception — if
    the e-ink or CANbus app must be rebuilt mid-race, a stale Supervisor
    blocks it and needs 'ha supervisor update' first (internet required).
    Also clarifies 'Supervisor' = the HAOS software component, not a person.
2026-06-19 Build slcan integration (transport + add-on 0.8.0)
    The SH-C31G was reflashed candleLight/gs_usb -> slcan (the gs_usb RX path
    broke on the HAOS kernel). Migrate the software to slcan:
    - solarcar_can/transport.py: add SlcanTransport (python-can slcan over the
    serial port) + find_slcan_port (CAN_PORT override, else auto-detect
    ttyACM*/COM). open_transport() now selects via CAN_TRANSPORT, defaulting
    to slcan; gs_usb and socketcan branches kept for reflash-back. Lazy
    imports so the module loads without pyserial/can.
    - PC CLI tools unchanged — they go through open_transport().
    - Add-on -> 0.8.0: can_reader.py opens the adapter as an slcan serial port
    and auto-detects/re-detects it (ha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
    [can_reader.py, config.yaml, transport.py]
2026-06-25 E-ink: HA IP / "Pi Offline" line in the header (add-on 1.5.0)
    Show the Pi's LAN address and HA port (e.g. "IP: 10.116.80.162:8123")
    between the title and the clock, or "Pi Offline" when Home Assistant is
    unreachable or the address can't be determined.
    - ha_client.host_ip(): discovers the primary LAN IPv4 from the Supervisor
    /network/info API (cached, last-good kept on a failed refresh). Needs the
    new hassio_api capability; config.yaml bumped to 1.5.0.
    - header_address(): "IP: <ip>:<port>" when reachable, else "Pi Offline".
    - Drawn solid, with NO partial-refresh region of its own, so it repaints
    only on full-screen refreshes - never on the high-frequency per-region
    updates (speed/tem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
    [config.py, config.yaml, display.py, ha_client.py, layout.py, panel.py, render.py]
2026-06-25 mapping: plot the viewing device on the course map (browser geolocation)
    build_viewer.py: add a "Locate me" control that uses navigator.geolocation
    .watchPosition to plot wherever the viewing phone/laptop is as a blue
    "This device" dot + accuracy ring, kept live. The dot is added to the map
    (not the route layer) so switching day tabs never clears it; the map isn't
    auto-panned (the course stays framed) and the button recenters on demand.
    Falls back gracefully with a clear label when blocked - notably "Needs
    HTTPS", since browsers only grant geolocation in a secure context.
    viewer.html regenerated. This is the file embedded into Home Assistant as a
    new full-screen "Course" view (iframe -> /lo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
2026-06-27 docs: Pi zero-RX saga — clean-HAOS T0 fail, 6.6 rollback staged, debug plan
    Overturns the "gs_usb kernel regression" root cause: slcan (a different USB
    stack) also gets 0 RX on the Pi, confirmed confound-free (clean HAOS 18.0,
    battery proven live by the laptop decoding 156 frames the same minute). Fault
    is Pi-host-specific (VL805/xHCI/HAOS-kernel receive path), not the CAN driver.
    - DEBUG-pi-rx-slcan-20260624.md: full write-up — T0 (clean latest-HAOS) fail,
    raw-serial split (control works, streamed bulk-IN doesn't), 6.6 rollback +
    dry-run, USB descriptors (full-speed, 64B bulk-IN behind internal-hub TT),
    powered hub relocates the TT, loopback unavailable on this firmware build.
    -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
2026-06-27 docs: Pi zero-RX deep-dive (6.6 rollback) + socketcan shop test; loopback retracted
    Tested the kernel-rollback hypothesis at home (HAOS 15.0 / kernel 6.6.74,
    adapter reflashed to candlelight/gs_usb). Attempted a battery-free RX verdict
    via gs_usb internal loopback — then a control run on the known-good laptop
    (which decodes 156 real frames) returned the SAME 3-echo/0-looped result, so
    the loopback test is invalid and its numbers (Pi "20%", hub "0%", "6.6 no win")
    are RETRACTED in the doc.
    What stands (real-frame only): Pi receives 0 frames on 6.12/6.18 while the
    laptop decodes the same bus. Whether 6.6 fixes it is OPEN — only the real
    battery on 6.6 (direct) can answer it. The VL805/boo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
    [socketcan_listen.py]
2026-06-29 docs/tools: RPi OS battery-test rig + shop runbook
    - tools/canbus_smoketest_rpios.sh: native candump smoke test for the RPi OS
    CAN-debug rig (gs_usb/can0) - the non-HAOS "is it the VL805 or HAOS?" test.
    - docs/SHOP-RUNBOOK.md: one-command web-terminal procedure for the on-Pi
    battery test, result interpretation, and the revert path.
    - .gitignore: ignore prompt-history*.md (contains pasted throwaway creds).
2026-06-30 E-ink header: stacked Router (LAN) + Hotspot (public) IPs
    Replace the single "IP: <lan>:8123" header line with an "IP:" heading and
    up to two small stacked rows: "Router:" (the on-car Ethernet router LAN IP,
    for crew near the car) and "Hotspot:" (the public IP via api.ipify.org, for
    crew far down the course). Either link may be absent, so the hotspot's own
    Wi-Fi LAN IP is shown as a local fallback and there is always >=1 row; a lone
    "Pi Offline" when HA is unreachable or no address is known at all.
    Addresses are cached and refreshed off the hot loop (refresh_network spawns a
    short-lived thread, TTL ~4min) so the per-loop draw never blocks on the
    network; the block still repaints only on ful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
    [config.yaml, display.py, ha_client.py, layout.py, render.py]
2026-06-30 E-ink header: Hotspot row shows the local hotspot IP, not the public IP
    Switch the second header row from the public IP (api.ipify.org) to the Pi's
    own LAN IP on the phone hotspot. Both rows are now local LAN addresses:
    "Router" = the on-car Ethernet router (no internet, backup when out of cell
    range) and "Hotspot" = the phone-hotspot LAN (for people who join the hotspot
    and so also get an internet connection). This is a reliable connect target
    (the public IP is usually behind carrier CGNAT and not reachable inbound).
    Drops the ipify lookup entirely, so refresh_network() now only hits the local
    Supervisor /network/info - no external call on the loop. render/layout are
    unchanged (same two-ro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
2026-06-30 addon 0.9.0: revert to SocketCAN/candlelight (slcan was a sleeping-battery confound)
    The slcan migration was built on the "gs_usb RX is broken on the Pi" theory,
    which turned out to be a SLEEPING-BATTERY confound (2026-06-29): the BESTGO
    stays CAN-silent until woken, so every host (laptop AND Pi) read 0 frames. Once
    the pack was woken via Bluetooth, candlelight/gs_usb -> SocketCAN can0 received
    fine on the laptop (170), RPi OS (179), and HAOS (169 frames, all 14 IDs).
    So revert the add-on to the proven SocketCAN/candlelight path:
    - can_reader.py: open_bus() -> can.Bus(socketcan, can0); find_port() -> can0_ready()
    - run.sh: bring up can0 via `ip link` (needs NET_ADMIN) instead of slcan seria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
    [can_reader.py, config.yaml, deploy_addon.py]
2026-07-09 E-ink: flip the whole panel 180deg for upside-down mounting
    The display is physically mounted inverted relative to the rendered frame.
    Rotate every buffer 180deg at the panel-push layer (panel.py) so the layout
    and partial-refresh regions stay in natural reading coordinates while both
    full and partial refreshes flip consistently: a region box (x0,y0,x1,y1)
    maps to (W-x1,H-y1,W-x0,H-y0), and the cropped tile is rotated too. All
    region x-coords and W are multiples of 8, so flipped columns stay
    byte-aligned. render() output is unchanged, so the 48 golden hashes still
    pass. Bump add-on 1.6.1 -> 1.6.2.
    [config.yaml, panel.py]
2026-07-09 E-ink: draw a "POWERED OFF" splash on shutdown, then deep-sleep
    On SIGTERM (add-on stop / Pi shutdown) the loop's finally now settles the
    panel to a clean full-screen splash (team logo + title + "POWERED OFF" /
    "Safe to unplug") and deep-sleeps it, instead of only sleeping when awake.
    This stops the panel being caught mid-refresh as the Pi cuts power (the
    "turns on last minute" flash), and leaves an intended image frozen with zero
    power. If the display was toggled off via HA, it stays blank instead.
    render_splash() reuses the dashboard logo/title styling; a larger 120px logo
    variant and two splash fonts are added in layout. The splash is pushed
    through the same panel path as the dashboard,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
2026-07-09 E-ink: lightning bolt on the battery when charging (new HA entity)
    Add a configurable charging-state entity (option `ent_charging`, default
    binary_sensor.bestgo_charging) read each slow poll via read_charging(); when
    it reads on/charging/true a lightning bolt is drawn centred on the battery
    icon - filled white with a black outline so it stays visible over both the
    black SoC fill and the empty white area. Charging is threaded through
    render() and region_snaps() (batt region) so the bolt appears/clears on a
    partial refresh. New option added to config.yaml options+schema and exported
    in run.sh.
    render() gains charging=False (default preserves every existing frame:
    golden baseline diff is +3 ch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
2026-07-10 E-ink: stop warning on unchanging data; aux SoC, unit relabel, startup message
    A value that stops changing is expected (a parked car, a settled temperature),
    so it no longer produces anything on screen:
    * Drop the "<value> not updating" warning chips entirely.
    * The "!" marks now come from alerts.device_marks() - ONLY values fed by a CAN
    device that is off the bus. Age-based staleness stays internal, where it
    still infers a device outage when the health sensors say nothing and still
    suppresses a "high temp" warning raised off a frozen reading. A high
    temperature never draws a "!"; it only raises its warning chip.
    Fix "CAN adapter disconnected" while sensor.canadapter_status reads 1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
    [alerts.py, config.py, config.yaml, display.py, ha_client.py, layout.py, panel.py]
2026-07-10 E-ink: ticking 12h clock with seconds, 1s poll, aux battery status + toggle
    * Clock is now 12-hour with seconds and no AM/PM ("2:32:07"), so the ticking
    seconds show at a glance that the panel is still refreshing. The widest form
    ("12:00:00") is 136px and lands at x=646, clearing both the clock region
    (x0=608) and the header IP block (right edge 636).
    * speed_poll default 2.5 -> 1 second.
    * Aux battery gains a status entity (ent_aux_status, placeholder
    binary_sensor.aux_battery_status). Only an EXPLICIT "down" counts: it raises
    an "AUX battery disconnected" warning (priority 94, just under the CAN
    devices) and puts a "!" beside the AUX reading. A missing/unknown placeholder
    sta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
    [alerts.py, config.py, config.yaml, display.py, panel.py, render.py]
2026-07-10 E-ink: split left pane into speedometer | odometer (new HA entity)
    The left-top pane is now two side-by-side panes. The speedometer moves to the
    left (centre 228 -> 120) and a boxed ODOMETER readout of the total distance
    travelled takes the right, echoing the gauge's LABEL / value / unit stack.
    * New `ent_odometer` option (placeholder sensor.odometer). Value AND unit come
    straight from Home Assistant, untouched, exactly like the speedometer; a
    missing entity reads "--". A failed read keeps the last total rather than
    blanking it.
    * New "odo" partial-refresh region (240,50,448,298); "speed" narrows to
    (8,50,232,298). Both x-bounds stay multiples of 8, so the 180-degree flip's
    W-x ma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
    [config.py, config.yaml, display.py, layout.py, panel.py, render.py]
2026-07-10 E-ink: friendlier labels - Battery/Motor disconnected, DISTANCE
    Rename the user-facing text only:
    "BESTGO disconnected" -> "Battery disconnected"
    "EZkontrol disconnected" -> "Motor disconnected"
    "ODOMETER" panel label -> "DISTANCE"
    The warning KEYS (can_bestgo, can_ezk) are deliberately unchanged: the HA
    dashboard's per-warning hide buttons key off them, so renaming them would
    silently un-hide anything the user had hidden. The ent_odometer option keeps
    its name too - it isn't user-visible on the panel.
    The shorter chip texts also leave more room in the warning bar (Battery 289px,
    Motor 271px, vs 347px for the CAN adapter).
    Goldens regenerated (66 hashes), 32 unit tests pass. Bu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
    [alerts.py, config.yaml, display.py, render.py]
2026-07-10 New team logo; archive the old one
    Swap display/addon/logo.png for the new team logo and keep the previous one at
    archive/old_logo.png.
    Verified through the 1-bit silhouette pipeline at both sizes it is used: the
    header (40px, 32% ink) and the shutdown splash (120px, 25% ink). It thresholds
    cleanly - the sun fills solid and the mountain reads as an outline, since its
    near-white fill sits above the 242 cutoff in _load_logo(). No blob, no dropout.
    Golden baseline regenerated: every frame carries the header logo, so all 66
    hashes move. 32 unit tests pass. Bump 1.7.1 -> 1.7.2 so the Pi rebuilds and
    picks up the new asset.
    [config.yaml]
2026-07-10 E-ink: widen the speed panel, shrink DISTANCE to 85%
    Rebalance the left-top split. The divider moves 236 -> 268, so:
    speed pane 224px -> 256px (gauge radius 86 -> 96, centre 120 -> 136)
    odo pane 208px -> 176px (85% of before, as asked)
    Both region bounds stay multiples of 8 - speed (8..264), odo (272..448) - so
    the 180-degree flip's W-x mapping still lands on byte-aligned columns
    (536..792 and 352..528). The divider at x=268 still sits in the 264..272 gap
    BETWEEN the regions, so no partial refresh repaints it and it cannot ghost.
    F_ODO drops 40 -> 32 so the narrower box still holds a decimal comfortably:
    "1,284.6" is 134px against a 148px budget. A six-figure total now even kee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
    [config.yaml, layout.py]
2026-07-10 E-ink: shutdown splash is now just the logo + "Powered Off"
    Drop the title and the "Safe to unplug" subtitle. The splash is the team logo
    scaled to 465x330 (58% of the width, 69% of the height - the logo is wider than
    tall, so height binds) with "Powered Off" centred underneath. The logo + gap +
    caption stack is centred as a whole rather than positioned from a fixed top.
    The new higher-quality logo carries a large size well: the sun fills solid and
    the mountain reads as clean linework at 330px.
    F_SPLASH_SUB is removed - nothing uses it now. Bump 1.7.3 -> 1.7.4.
    [config.yaml, layout.py, render.py]
2026-07-10 E-ink: clock ticks every second while the display is on (clock_tick)
    The clock region is now pushed every loop, so the seconds always tick and the
    panel visibly proves it is alive. Because a tick counts as a reason to push, the
    panel never reaches the idle branch: it does not deep-sleep while the display is
    on. That is a deliberate trade - Waveshare would rather an idle panel were
    slept, and this costs one small partial refresh per second of wear. The HA power
    toggle and the shutdown splash still rest it.
    * New `clock_tick` option (default true). Off restores the previous behaviour
    exactly - only real telemetry refreshes the panel and IDLE_SLEEP can sleep it -
    so the idle path stays liv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
2026-07-10 docs: sleeping-battery warnings, RPM->MPH conversion, race-prep checklist
    README + CANbus_data/README: call out that a CAN-silent BESTGO pack is
    almost always asleep rather than a CAN/USB/VL805 fault. An idle bench pack
    transmits nothing on every host, which is what drove the multi-week hardware
    hunt resolved 2026-06-29 by waking the pack.
    README §9.5: drivetrain math for the speed sensor — 55/11 = 5:1 reduction,
    73.199108 in wheel circumference, so MPH = RPM * 0.01386347.
    README §11: reprioritized student to-do around the Texas deadline.
    Add the 2026 challenge checklist doc. Ignore MS Office ~$ owner/lock files.
2026-07-11 CANbus: only publish a device's sensors when a fresh frame arrived
    Replace the "if d.data:" push gate with a per-device good_data flag that means
    "a fresh frame for this device arrived since its last push". Once a device had
    ever decoded a frame, d.data stayed truthy forever, so a device that went
    silent kept re-publishing stale sensor values (only its *_status sensor
    correctly dropped to 0).
    good_data is SET only on the device that owns an incoming frame (arbitration
    ids are disjoint - EZkontrol 0x180117EF/0x180217EF, BESTGO 0x351..0x379 - so a
    frame matches exactly one decoder) and CONSUMED (reset to False) right after
    the device is pushed. Setting it on only the owner matters: writing ev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
    [can_reader.py]
2026-07-11 CANbus: bump 0.9.0 -> 0.9.1 for the fresh-frame push fix
    Version bump so the Supervisor rebuilds the local add-on and picks up the
    can_reader.py change (the Dockerfile COPYs the source in, so a rebuild is
    required). No schema change.
    [config.yaml]
2026-07-11 Add DEPLOYING_ADDONS.md - build & push guide for both add-ons
    A root-level guide covering how to deploy the two local HA add-ons (e-ink
    solar_epaper, CANbus solarcar_canbus) and the traps we've actually hit:
    version bump required (Dockerfile COPYs source), reload/update/rebuild flow via
    the ha CLI and Supervisor REST, saved options overriding changed defaults,
    merging new schema keys, the silent options-POST failure (post from a file),
    Protection Mode resetting on rebuild, CRLF vs LF on run.sh, the vendored
    solarcar_can package + sync_addon.py, e-ink byte-aligned partial-refresh
    regions and the 180-degree flip, reading the Pi IP from status.json, and
    on-Pi backups for rollback.
    Co-Authored-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
2026-07-11 Speed sensor: use documented drivetrain values; tidy README section 10
    eink_messages.yaml: sensor.solar_car_speed now converts motor rpm to mph
    with the documented drivetrain (73.199108 in wheel circumference, 5:1 gear
    = 0.01386347 mph/rpm) instead of the placeholder 20 in / 1:1 values.
    README: renumber the RPM->MPH section 9.5 -> 10 (Andy 10 -> 11, Student
    11 -> 12), nest its subsections as 10.1-10.5, drop the redundant h1 and
    leftover rule separators, and add a 10.5 Live Sensor note pointing at
    sensor.solar_car_speed / the add-on ent_speed option.
2026-07-11 Add QR codes and Telemetry user guide docs
    Two Word documents for race-day reference: printable QR codes and the
    telemetry system user guide.
2026-07-11 CANbus: bootstrap sensor entities so they always show in HA
    The add-on creates sensor.ezkontrol_* / sensor.bestgo_* via REST /api/states,
    and only once a fresh frame populates each field -- and REST-created states
    don't survive an HA restart. So before the CAN bus comes up the dashboard shows
    "entity not found" and there's no history to browse.
    Add an HA-side bootstrap (no add-on change): a python_script seeds every known
    sensor as "unavailable" if it doesn't already exist, run on the
    homeassistant.start event by an automation. Cards render and history stays
    continuous while the bus is silent; live values from the add-on are never
    clobbered (existence check), and there's no per-interval chu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
    [gen_ha_bootstrap.py]
2026-07-11 Add aux battery low-charge alarm + warning to e-ink display
    Sounds a configurable file (via ha_client.play_sound) as the aux battery
    SoC drops past each configured level and shows an "AUX battery low"
    warning while it stays in the alerting zone.
    - config: aux_low_levels ("10, 5, 2"), aux_low_sound, aux_alarm_player
    - alarm is edge-triggered per level with hysteresis so it doesn't nag
    every poll or retrigger on a jittering reading; already-low levels are
    armed at startup so a restart while low doesn't blast the sound
    - warning gated by aux_enabled and suppressed when HA is unreachable
    - e-ink addon version 1.9.0; 11 new unit tests, goldens unchanged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
    [alerts.py, config.py, config.yaml, display.py, ha_client.py]
2026-07-11 E-ink 1.10.0: publish Pi router/hotspot IP + QR sensors; refresh dashboard snippets
    Add-on now republishes the two LAN addresses it already resolves for the panel
    header as sensor.pi_router_ip / sensor.pi_hotspot_ip, each carrying an offline-
    generated QR data-URI of the HA URL (no external QR service, so it works on the
    car's no-internet router LAN). State is the IP when the link is up, "unavailable"
    when down, so a dashboard can show each QR only while connected. Dedup + heartbeat
    so unchanged links don't churn and the REST-published states self-heal after an
    HA restart.
    - Dockerfile: add qrcode (Pillow already present); imported lazily so the module
    still loads without it and publishin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
    [config.py, config.yaml, display.py, ha_client.py]
2026-07-12 CANbus: deploy 0.9.2; fix deploy tooling and document /addons backup slug-shadowing
    - bump add-on to 0.9.2 (ships the logging cleanup)
    - deploy_addon.py: key auth first (SSH add-on disables passwords when a key
    is configured), CRLF->LF normalization, backups to /addons/.backups/,
    bash -lc wrapper for ha CLI (SUPERVISOR_TOKEN), ghcr.io check before rebuild
    - DEPLOYING_ADDONS.md: same-slug .bak folders under /addons shadow the real
    add-on in the store scan (arbitrary order) - backups now live one level down
    [config.yaml, deploy_addon.py]
2026-07-12 Fix reviewed defects in both add-ons (CANbus 0.9.3, e-ink 1.11.0)
    CANbus reader:
    - HA pushes moved to a dedicated pusher thread with a bounded drop-oldest
    queue - a slow/restarting HA can no longer stall bus.recv() and drop frames
    - all scheduling on time.monotonic() (NTP steps froze pushes / faked status=0)
    - run.sh: bare `ip link set can0 down` no longer kills the script under
    bashio errexit
    - network-monitor thread guarded against unforeseen exceptions;
    default_gateway also catches ValueError from malformed /proc/net/route
    - can0 going administratively down while open is now detected (recv just
    times out), so canadapter_status stops claiming 1
    E-ink display:
    - render loop survive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
    [can_reader.py, config.yaml, display.py, ha_client.py, patch.py, render.py]
2026-07-12 deploy_addon.py: support both add-ons via --addon canbus|eink
    Gives the e-ink deploy a durable home (it previously lived in a scratchpad
    per docs/DEPLOYING_ADDONS.md). Used to ship e-ink 1.11.0.
2026-07-15 docs: reference diagram3 in README power architecture section
    Add a Power architecture subsection under System overview describing the
    48V traction and 12V accessory power domains and the galvanic isolation
    barrier bridged by the isolated USB-CAN adapter.
2026-07-15 Update Telemetry user guide with power cord note
    Added note about power cord removal for Raspberry Pi.
2026-07-16 docs: add system diagrams to telemetry user guide
    Add a "How the system works" section with the data-flow, network, and
    power diagrams, each tied to the operational steps a traveler follows.
2026-07-21 Update telemetry user guide with shutdown note
    Added a note about shutting down the Raspberry Pi before power removal and clarified device connection instructions.
2026-07-21 Update boot status description in telemetry guide
    Clarified the boot status indication of the Raspberry Pi in the user guide.
2026-10-03 CANbus 0.10.0: high-resolution mode switch + telemetry CSV log/export
    - input_boolean.canbus_high_res (ha/packages/canbus_controls.yaml) is polled
    every 2 s; while on, both devices push every high_res_push_interval (0.5 s)
    instead of 2/5 s. Only changed values are re-POSTed at the fast rate;
    status sensors and summary log lines keep the normal cadence.
    - telemetry_log.py: one wide CSV row per tick (every sensor of both devices
    + health columns) to /share/solarcar_telemetry/telemetry-YYYY-MM-DD.csv,
    pruned after telemetry_log_keep_days; HTTP export page on :8099 (also HA
    ingress sidebar panel "Telemetry Export") downloads any time window as a
    single CSV. New sensor.canbus_teleme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
2026-10-03 PI_TODO: CANbus 0.10.0 deployed and verified 2026-10-03
2026-10-03 CANbus 0.11.0: replace high-res toggle with a live update-interval setting
    input_number.canbus_update_interval (seconds, 0.1-60) is polled every 2 s
    and overrides both devices' push intervals and the telemetry-log tick; a
    missing/unknown helper falls back to the configured per-device intervals.
    Drops the high_res_push_interval / telemetry_log_interval options; the CSV
    meta column high_res becomes interval_s (interval in force for that row).
    - package yaml defines the input_number (mode: box); dashboard card gains
    0.2 / 0.5 / 2 / 10 s preset buttons
    - deploy_addon.py: prunes saved option keys the new schema dropped before
    the rebuild; --with-packages reloads input_number + input_boolean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
    [can_reader.py, config.yaml, deploy_addon.py, export_telemetry.py]
2026-10-03 CANbus 0.12.0: export straight from HA history, no CSV logging; editable entity list
    - Remove the continuous CSV log (telemetry_log.py, /share mount,
    telemetry_log* options, sensor.canbus_telemetry_log). The export page
    (:8099 / ingress) now pulls /api/history/period for the selected
    entities on demand, in 1 h chunks, and pivots it into one wide CSV:
    first row = state at window start, then one row per change with the
    other columns carried forward. Entities that don't exist (e.g. after an
    HA restart) are blank columns; unknown/unavailable are blank cells.
    - Entity list is editable on the page: tick/untick, add any HA entity from
    a picker of everything HA has, remove added ones;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
2026-10-04 Telemetry guide V.2: full ToC, how-it-works, common problems
    Rewrote V.2 for crew who don't know the system: split connecting and
    data-download out of the start-up steps, added a quick start and a
    shutting-down section, and said what you should SEE at each step (the
    e-ink clock, not the image, proves the Pi is running).
    New sections: "How the system works" (data flow / network / power, with
    the three diagrams) and "Common problems" (symptom lookup table plus a
    fix for each). The CAN-adapter entry now says to restart the CANbus
    add-on after a USB replug - can0 comes back down and only run.sh ups it,
    which is why a bare replug often looks like it didn't work.
    Also commits the V.2 deletion of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
2026-10-04 E-ink 1.12.0: working "Connect to Pi" QR codes via HA-served PNG files
    The QR cards never rendered: HA's markdown card strips data: image URIs,
    which is how the `qr` attribute embedded the code. The add-on now writes
    the QR PNGs into HA's www folder (map: homeassistant_config ->
    /homeassistant/www/solarcar/qr_router.png, qr_hotspot.png), HA serves
    them at /local/solarcar/..., and sensor.pi_router_ip / pi_hotspot_ip
    carry `qr_path` instead of the base64 `qr`. Files are rewritten on IP
    change or if they go missing; an unwritable folder degrades to URL-only
    with one warning.
    - display/ha/dashboard_qr_section.yaml: markdown cards use qr_path with a
    ?v=<ip> cache-buster; one card per link, sho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
    [config.py, config.yaml, deploy_addon.py, ha_client.py]
2026-10-05 Telemetry processing: convert HA raw-readings export to parquet/CSV tables
    telemetry.py turns the 2026-10-03 raw readings .xls into a tidy long table,
    a 1 s wide table with derived power/energy/distance, an events log, and
    per-session and per-drive summaries.
    [channels.csv, drives.csv, events.csv, sessions.csv, solarcar_raw_readings_2026-10-03.xls, wide_1s.csv]
2026-10-05 CANbus 0.12.1: decode EZkontrol op mode 0/1 as Stop/Drive; document BESTGO capacity fields
    The op-mode table missed the 0/1 row that the spec splits across a page
    break, so Drive showed as "?(1)" and Stop as "Normal". BESTGO nominal and
    installed capacity report remaining Ah (== SOC % on the 100 Ah pack), not a
    fixed rating; spec comments corrected.
    [bestgo.py, config.yaml, ezkontrol.py, test_decoders.py]
2026-10-05 Telemetry analysis: overloads, motor thermal model, solar break-even, pack health, dashboard
    analysis.py adds controller-error context, a fitted motor heating model,
    a road-load fit with solar break-even speed, capacity and resistance
    estimates, per-drive charts and an interactive dashboard.html. telemetry.py
    now processes every export, adds regen energy and labels power cycles.
    New HA package solar_car_insights.yaml: range estimate, break-even speed
    and a predictive motor-heat warning on the e-ink message box (not deployed).
    [all_drives.csv, drives.csv, efficiency_vs_speed.csv, events.csv, health_history.csv, overloads.csv, sessions.csv, thermal_fit.csv]
2026-10-08 Telemetry: read the new CSV export, drop aux load, exclude low-speed data, add team pack
    - data_processing/ (renamed): exports live in raw/; telemetry.py now reads
    the add-on's wide CSV export (time_utc + entity columns) as well as the old
    .xls list, splits multi-day exports, and falls back to rpm for speed.
    tests/test_formats.py checks both formats give the same result.
    - Accessories run off their own battery: no aux term in break-even (now
    ~13.1 mph at 725 W), HA package and dashboard updated.
    - Below 8 mph the motor jumps around: those readings stay in the data but
    are left out of the efficiency and road-load fits; wheel-reversal metric
    removed.
    - make_team_pack.py builds team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
    [all_drives.csv, channels.csv, controller_errors.csv, data_dictionary.csv, drives.csv, efficiency_vs_speed.csv, events.csv, health_history.csv]
2026-10-08 update team_pack system
    [solarcar_raw_readings_2026-10-03.xls]
2026-10-09 Telemetry: brake-drag detection, efficiency breakdown, battery-vs-controller gap, day notes, team pack layout
    - analysis.py: per-drive driving-style/energy table (drive_efficiency.csv)
    flags brake drag (drive 4 on 3 Oct) and keeps it out of the efficiency and
    break-even fits; route was flat, so no grade term. New power_gap.json
    compares battery and controller current in the fast-logging stretch
    (0.99x + 1.8 A, ~95 W extra while driving). New charts: efficiency by
    drive, energy breakdown, battery vs controller.
    - notes/<date>.md holds the team's account of the day; shown in the
    dashboard and the team README.
    - Dashboard reordered: day summary and story first, then efficiency,
    ba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
    [controller_errors.csv, data_dictionary.csv, drive_efficiency.csv, drives.csv, efficiency_vs_speed.csv, events.csv, health_history.csv, solarcar_raw_readings_2026-10-03.xls]
